AndreAndriotti/Echolee/README.md

# Echolee
Link to the presentation on YouTube: https://youtu.be/tTeqV6szZD4.
